gcronin/OnBoardDiagnostics/Schematics/LogicConnections.png

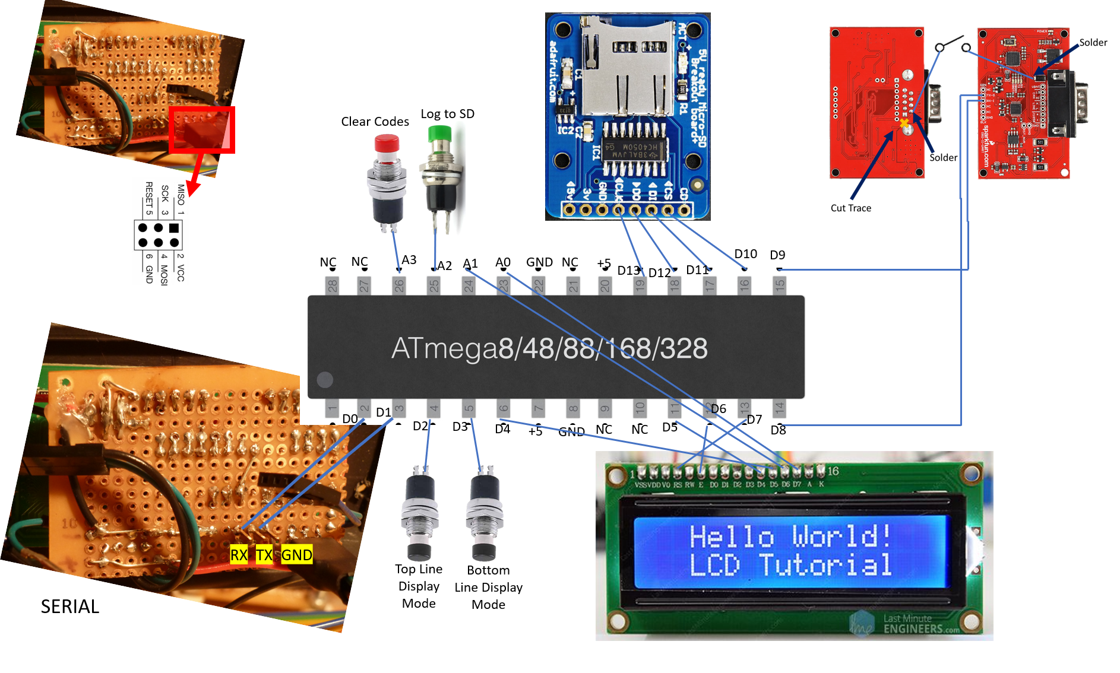
Schematics/LogicConnections.png
