gcronin/OnBoardDiagnostics/Pictures/P1040761.JPG

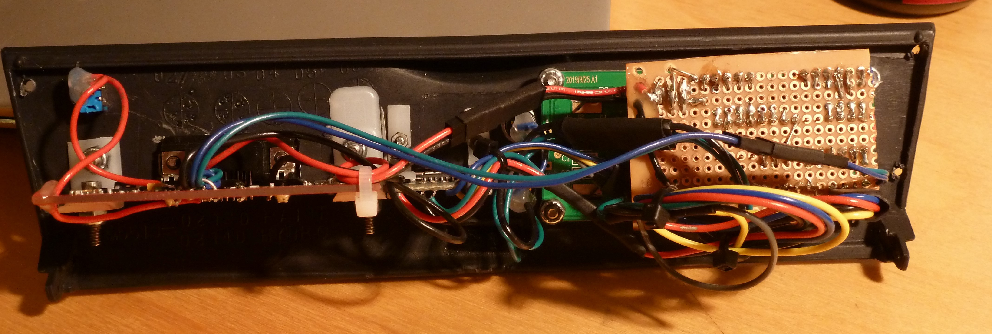
Pictures/P1040761.JPG
