gcronin/OnBoardDiagnostics/README.md

# OnBoardDiagnostics

This is a combination OBD code reader/clearer, OBD data display and SD datalogger based on the Sparkfun OBD-II UART board (https://www.sparkfun.com/products/9555).  The brains is an Atmega328p microcontroller.  Display is via a 16x2 LCD.  Two buttons control the data displayed on the top and bottom lines of the LCD.  A third button toggles datalogging to a micro-SD card.  A fourth button clears check engine error codes.

P1040786

P1040781b
