gcronin/OnBoardDiagnostics/Hookups.pptx

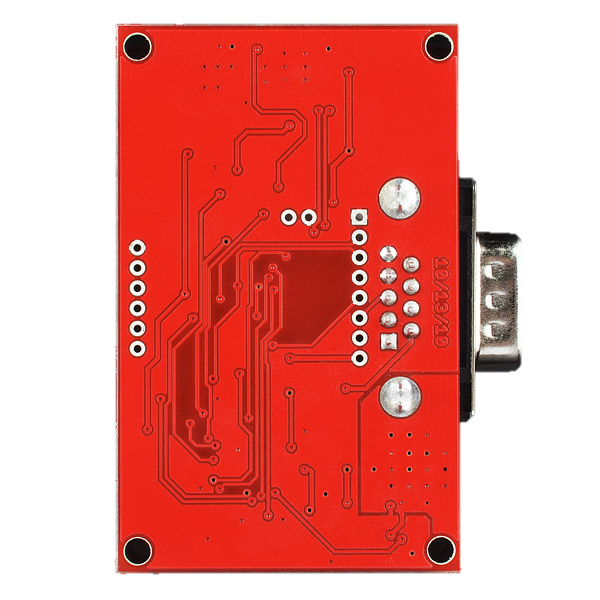
[picture p3: figure]
SparkFun OBD-II UART
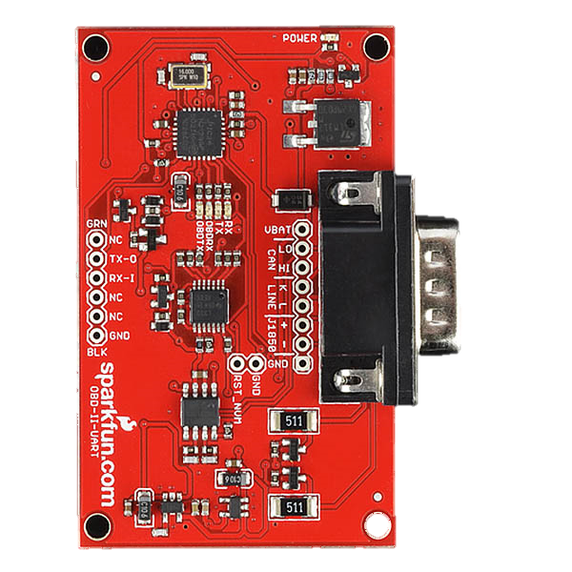
[picture p4: figure]
SparkFun OBD-II UART

Solder

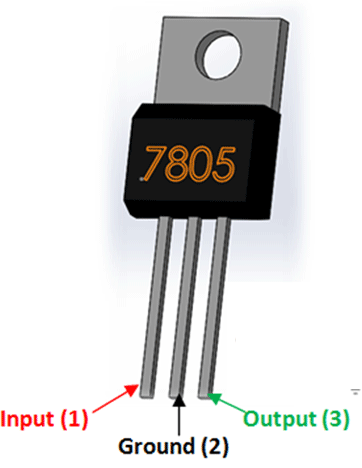
[picture p5: figure]

Solder

D8

Cut Trace

D9

## Slide 2

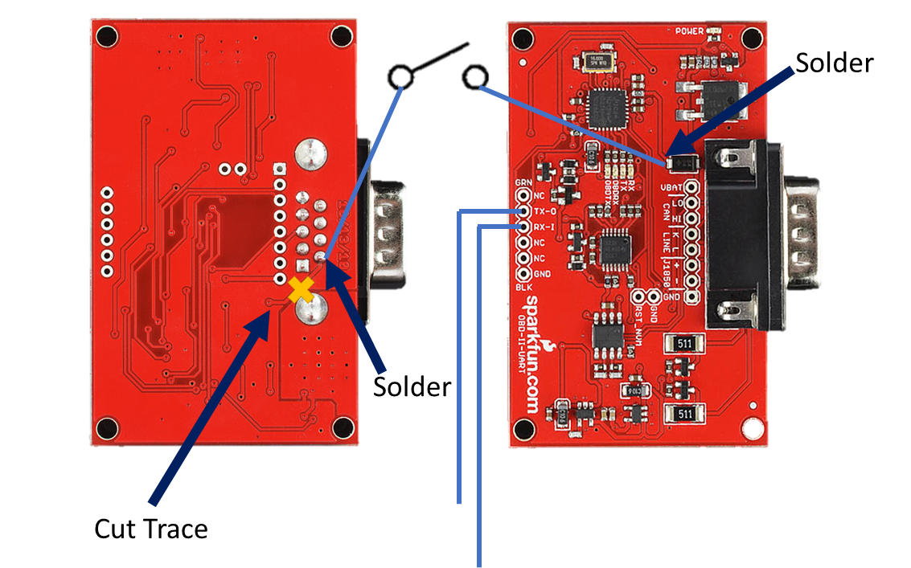
[picture p6: figure]
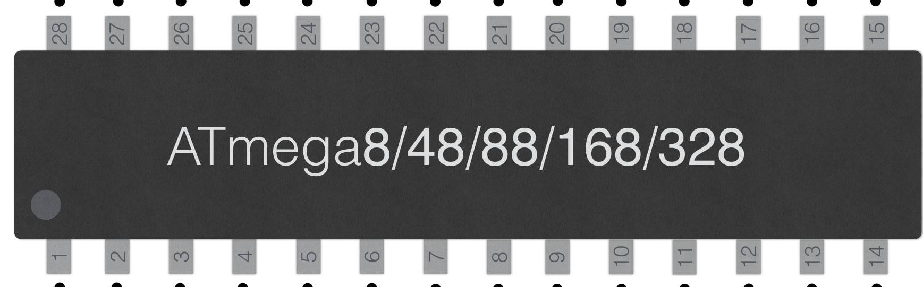
[picture p7: figure]

D9

D8

## Slide 3

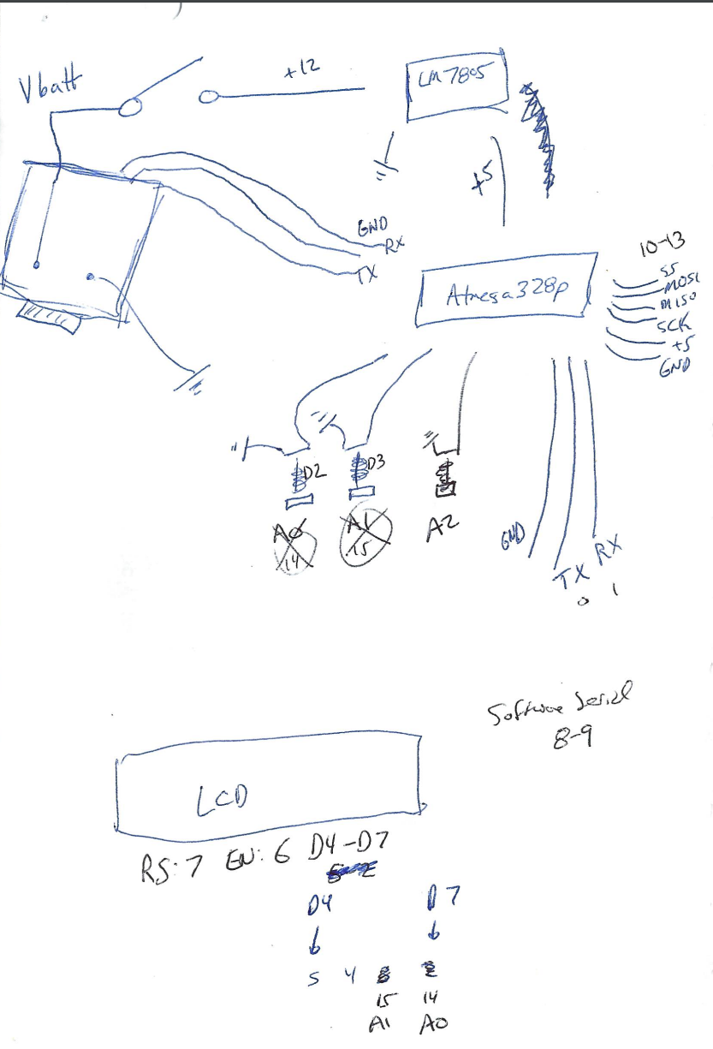
[picture p8: figure]
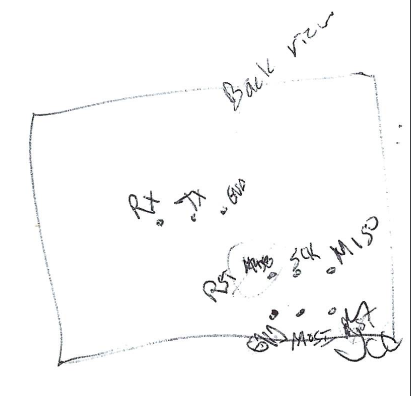
[picture p9: figure]
