gcronin/OnBoardDiagnostics/Pictures/P1040751.JPG

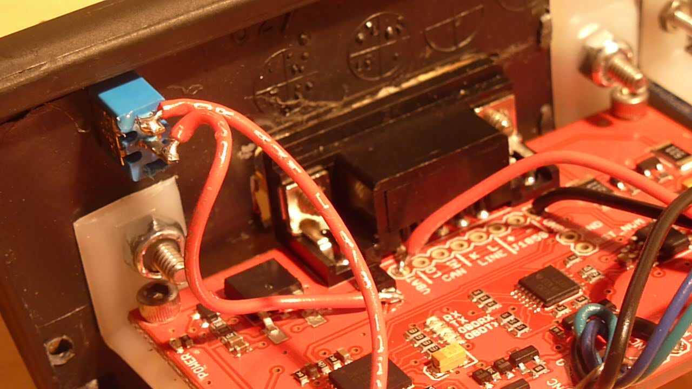
Pictures/P1040751.JPG
