gcronin/OnBoardDiagnostics/Pictures/P1040760.JPG

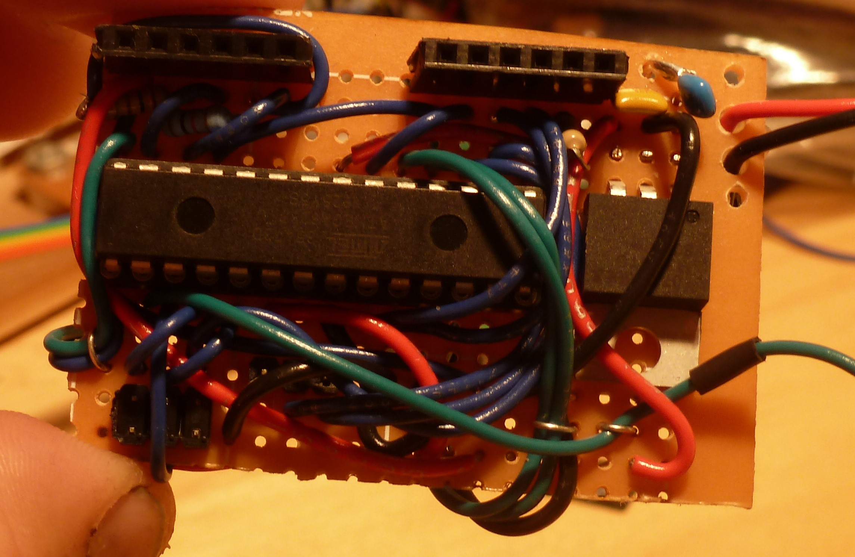
Pictures/P1040760.JPG
