gcronin/OnBoardDiagnostics/Pictures/P1040764.JPG

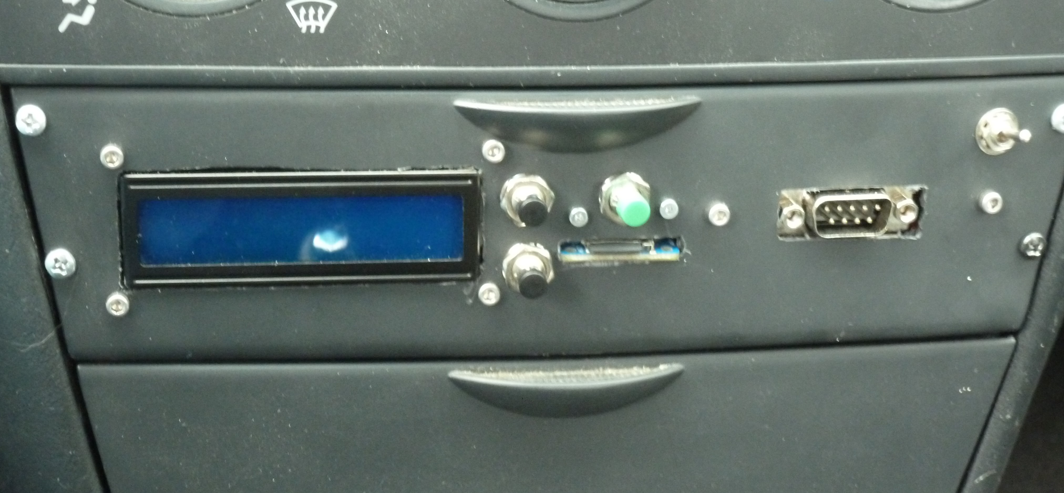
Pictures/P1040764.JPG
