gcronin/OnBoardDiagnostics/Pictures/P1040766.JPG

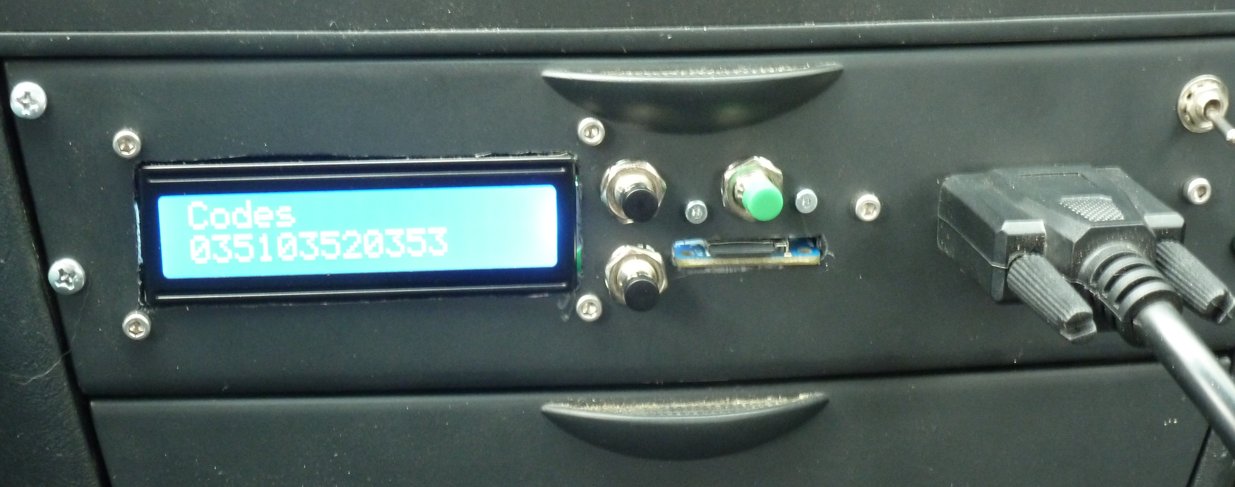
Pictures/P1040766.JPG
