gcronin/OnBoardDiagnostics/Pictures/P1040767.JPG

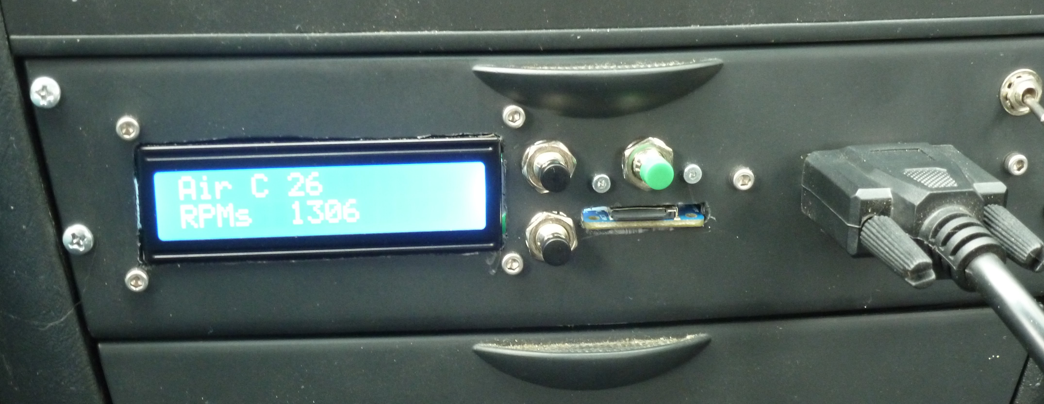
Pictures/P1040767.JPG
