gcronin/OnBoardDiagnostics/Pictures/P1040771.JPG

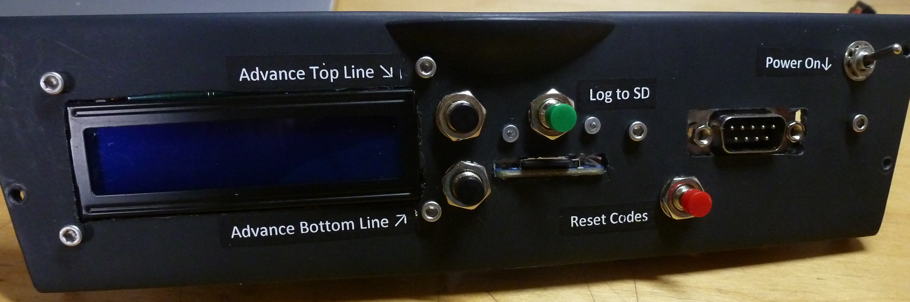
Pictures/P1040771.JPG
