gcronin/OnBoardDiagnostics/Pictures/P1040773.JPG

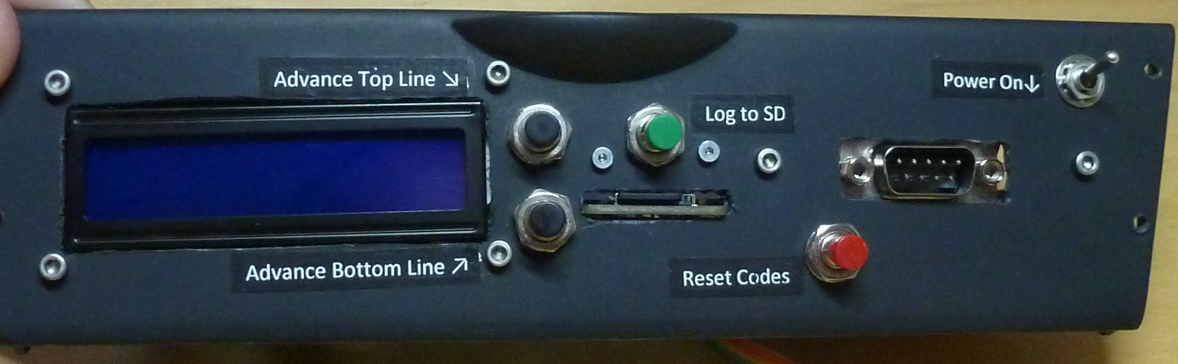
Pictures/P1040773.JPG
