gcronin/OnBoardDiagnostics/Pictures/P1040775.JPG

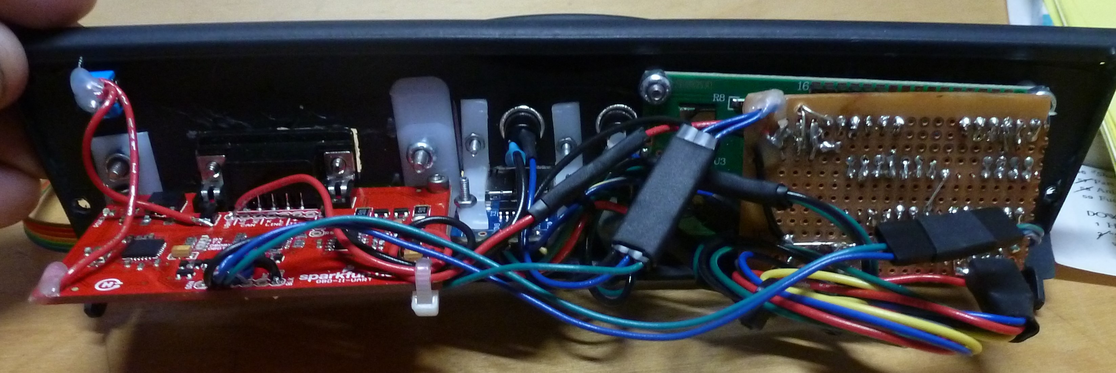
Pictures/P1040775.JPG
