gcronin/OnBoardDiagnostics/Schematics/schematic.png

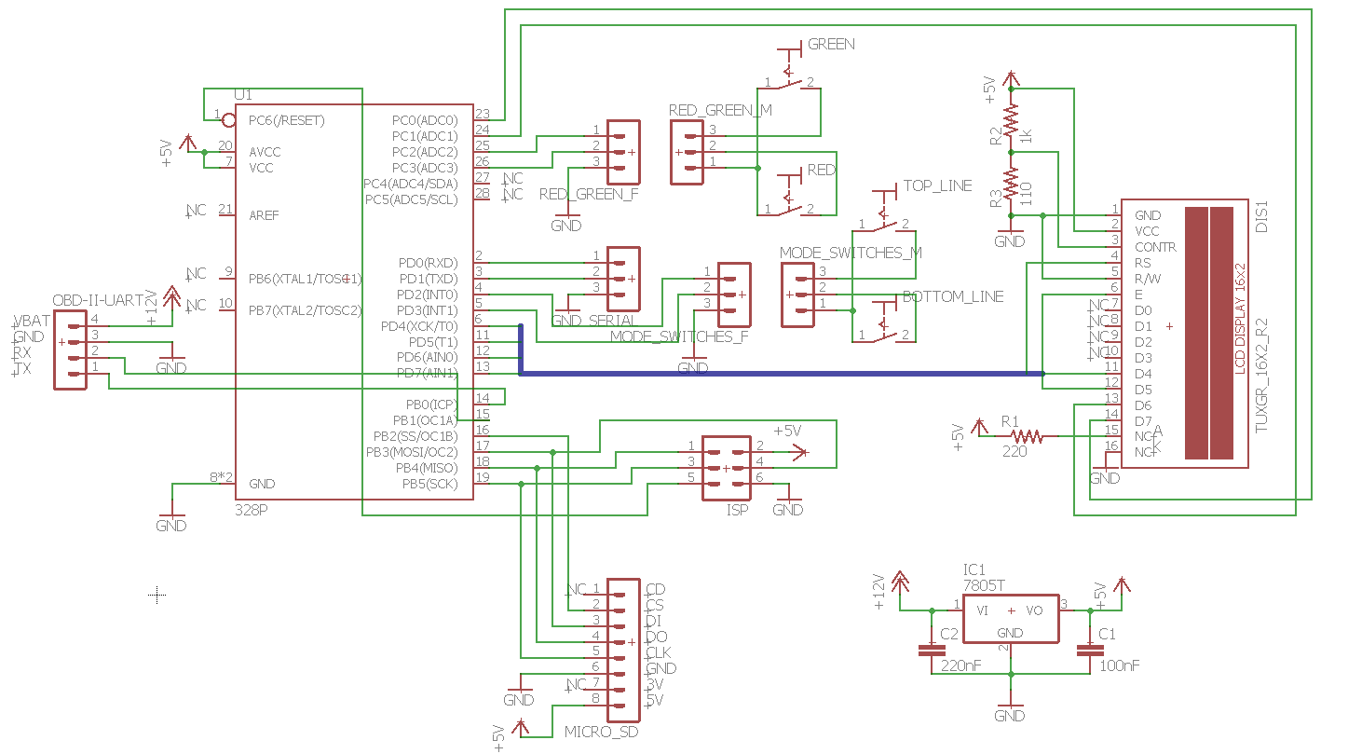
Schematics/schematic.png
