gcronin/OnBoardDiagnostics/Schematics/OBDboard.sch

## EAGLE design Schematics/OBDboard.sch (2022-06-27)

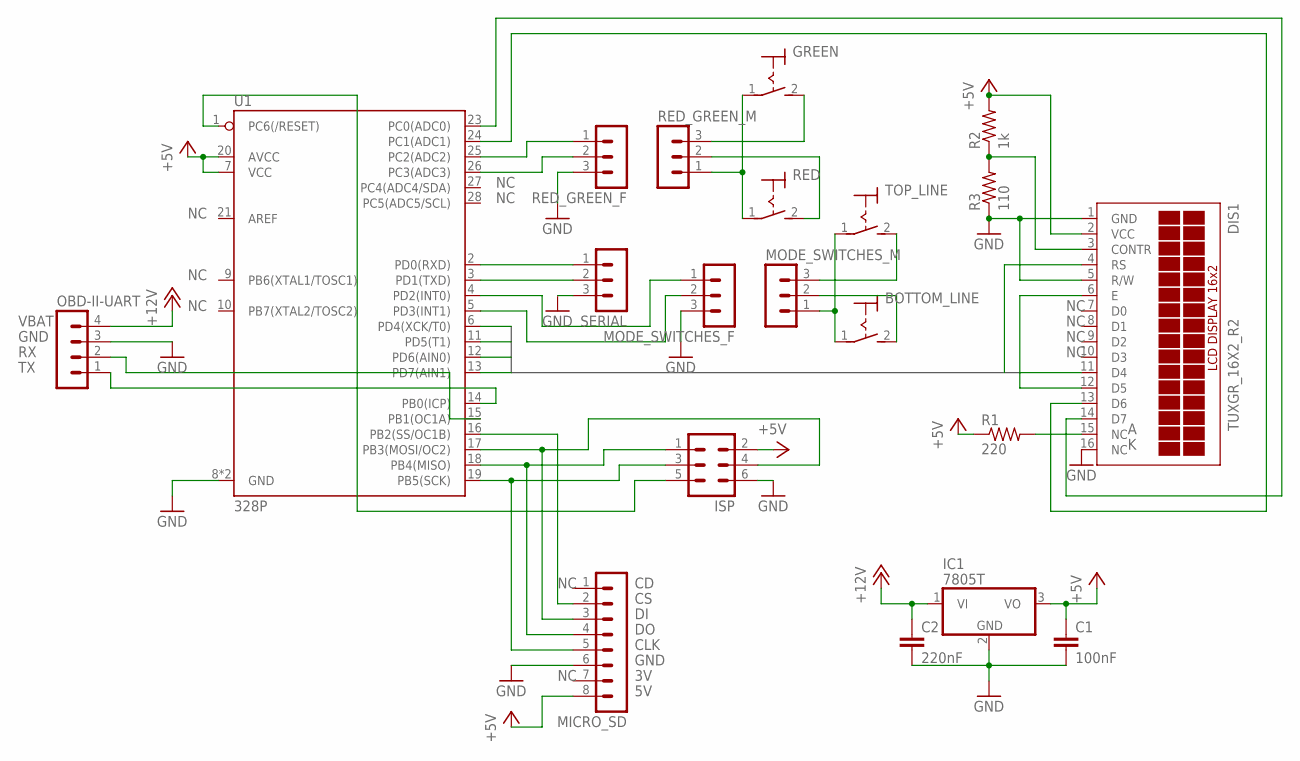
[picture p19: schematic OBDboard.sch]

Parts:
BOTTOM_LINE: MS243
C1: 100nF; C2.5-2
C2: 220nF; C2.5-2
DIS1: TUXGR_16X2_R2
GREEN: MS243
IC1: 7805T; TO220H
ISP: MA03-2
MICRO_SD: MA08-1
MODE_SWITCHES_F: MA03-1
MODE_SWITCHES_M: MA03-1
OBD-II-UART: MA04-1
R1: 220; 0207/10
R2: 1k; 0207/10
R3: 110; 0207/10
RED: MS243
RED_GREEN_F: MA03-1
RED_GREEN_M: MA03-1
SERIAL: MA03-1
TOP_LINE: MS243
U1: 328P; DIP28

Connections:
+5V: C1.1, DIS1.2 (VCC), IC1.3 (VO), ISP.2, MICRO_SD.8, R1.1, R2.2, U1.7 (VCC), U1.20 (AVCC)
+12V: C2.1, IC1.1 (VI), OBD-II-UART.4
A0: DIS1.14 (D7), U1.23 (PC0(ADC0))
A1: DIS1.13 (D6), U1.24 (PC1(ADC1))
A2: RED_GREEN_F.1, U1.25 (PC2(ADC2))
A3: RED_GREEN_F.2, U1.26 (PC3(ADC3))
D2: MODE_SWITCHES_F.1, U1.4 (PD2(INT0))
D3: MODE_SWITCHES_F.2, U1.5 (PD3(INT1))
D4: DIS1.12 (D5), U1.6 (PD4(XCK/T0))
D5: DIS1.11 (D4), U1.11 (PD5(T1))
D6: DIS1.6 (E), U1.12 (PD6(AIN0))
D7: DIS1.4 (RS), U1.13 (PD7(AIN1))
D8: OBD-II-UART.1, U1.14 (PB0(ICP))
D9: OBD-II-UART.2, U1.15 (PB1(OC1A))
D10: MICRO_SD.2, U1.16 (PB2(SS/OC1B))
GND: C1.2, C2.2, DIS1.1 (GND), DIS1.5 (R/W), DIS1.16 (NC), IC1.2 (GND), ISP.6, MICRO_SD.6, MODE_SWITCHES_F.3, OBD-II-UART.3, R3.1, RED_GREEN_F.3, SERIAL.3, U1.8 (GND)
MISO: ISP.1, MICRO_SD.4, U1.18 (PB4(MISO))
MOSI: ISP.4, MICRO_SD.3, U1.17 (PB3(MOSI/OC2))
unnamed: MODE_SWITCHES_M.3, TOP_LINE.2 (S)
unnamed: BOTTOM_LINE.2 (S), MODE_SWITCHES_M.2
unnamed: BOTTOM_LINE.1, MODE_SWITCHES_M.1, TOP_LINE.1
unnamed: DIS1.3 (CONTR), R2.1, R3.2
unnamed: RED.2 (S), RED_GREEN_M.2
unnamed: GREEN.2 (S), RED_GREEN_M.3
unnamed: GREEN.1, RED.1, RED_GREEN_M.1
unnamed: DIS1.15 (NC), R1.2
RESET: ISP.5, U1.1 (PC6(/RESET))
RX: SERIAL.1, U1.2 (PD0(RXD))
SCK: ISP.3, MICRO_SD.5, U1.19 (PB5(SCK))
TX: SERIAL.2, U1.3 (PD1(TXD))

Notes on the sheet:
CLK
GND
VBAT
