gcronin/OnBoardDiagnostics/(commit log)

2022-04-03 Working Serial Only
    [RPM Calculator.xlsx]
2022-04-14 Data Filtering
    Successfully tested previous, adding filtering for data. Added battery voltage check... does not work.
2022-04-20 Swapped Buttons to Interrupt Pins
    Hardware complete. Tested, working.
2022-04-24 Read Battery added... freezing
    Fixed mode 7
    [atrv_test.ino]
2022-05-27 Implement ATZ Reset
    Tested, working
    [atz_test.ino]
2022-06-06 More Examples
    [Car_to_PeerSeattle.xlsx, RPM_i5S.xlsx]
2022-06-16 Added LogToSD Button
2022-06-20 Cleaned Up Folders
    [Car_to_PeerSeattle.xlsx, RPM Calculator.xlsx, RPM_i5S.xlsx, speed_rpm1.xlsx]
2022-06-26 Implement Clear Codes, Parse Codes Nicer
    Also eliminate bug with Battery Voltage where gets stuck in infinite loop... better solution might be look for '>' end character rather than 'V'? Everything working here though.
2022-06-27 Renamed, Added Schematics
    [OBDboard.sch]
2022-06-27 cleanup images
    [OBDboard.sch]
2022-07-11 Initial Structure for Library
    [GearRatios.xlsx]
2022-07-21 Added Voltage
2022-08-19 Added More PIDS, Fixed Voltage
    Voltage still doesn't work reliable... get a lot of garbage.
    [Firmware.ino]
2022-08-28 Use of F() to reduce SRAM usage
    Opening SD card file log.txt was failing prior to this.
    [Car_to_PeerSeattle.xlsx, GearRatios.xlsx, RPM_i5S.xlsx, speed_rpm1.xlsx]
